Ajacks777/educational-speed-robot/hardware/3D_Design/3Dmodel.md

## 3D Robot Chasis Design & supporting software specifcations

#### Software:
AutoDesk Fusion 360
#### Print configuration:
BambuLab A1 mini PLA material

- layer height 0.2 mm
- infill Density 30%
- pattern gyroid
- nozzle temp 215 C
- bed temp 65 C

---
### 3D models
Bottom Chasis design with M.2 holes for motor mounts.
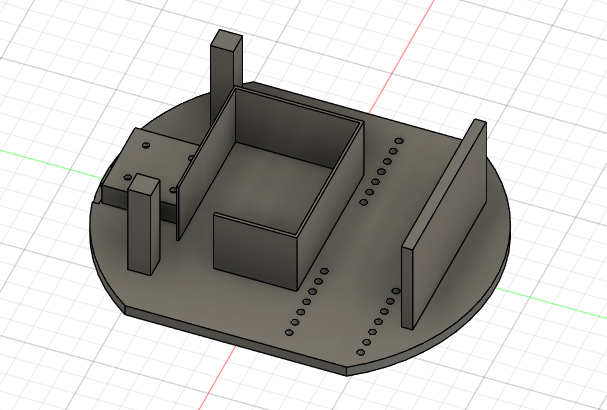
[picture p4: hardware/3D_Design/bottom.png]
Bottom chasis

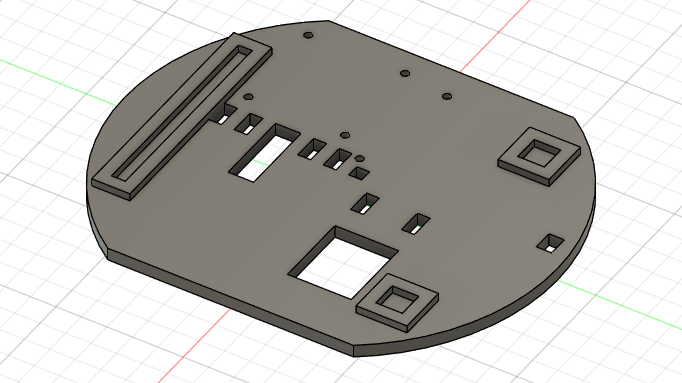
[picture p5: hardware/3D_Design/top_plate.png]
Top Plate attachment

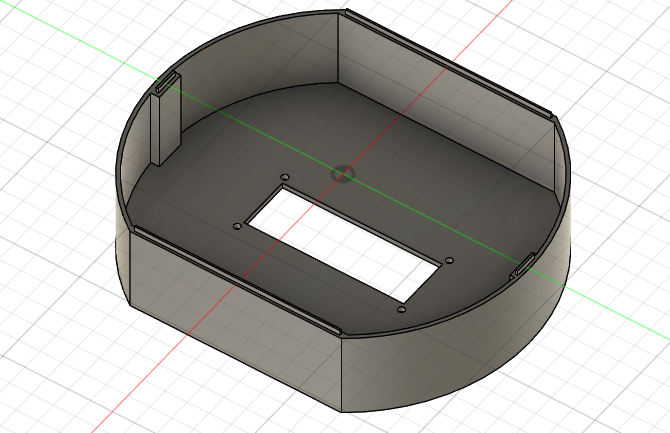
[picture p6: hardware/3D_Design/top_cover.png]
Cover plate

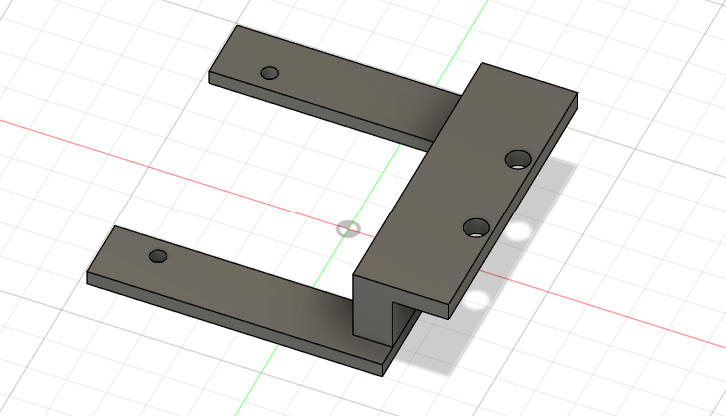
[picture p7: hardware/3D_Design/front_QTR_attachment.png]
Attachment for QTR reflectance sensor
